dkolhe21/rv32i_5stage/caravel_user_project/signoff/rv32i_top/metrics.csv

design | design_name | config | flow_status | total_runtime | routed_runtime | (Cell/mm^2)/Core_Util | DIEAREA_mm^2 | CellPer_mm^2 | OpenDP_Util | Final_Util | Peak_Memory_Usage_MB | synth_cell_count | tritonRoute_violations | Short_violations | MetSpc_violations | OffGrid_violations | MinHole_violations | Other_violations | Magic_violations | pin_antenna_violations | net_antenna_violations | lvs_total_errors | cvc_total_errors | klayout_violations | wire_length | vias | wns | pl_wns | optimized_wns | fastroute_wns | spef_wns | tns | pl_tns | optimized_tns | fastroute_tns | spef_tns | HPWL | routing_layer1_pct | routing_layer2_pct | routing_layer3_pct | routing_layer4_pct | routing_layer5_pct | routing_layer6_pct | wires_count | wire_bits | public_wires_count | public_wire_bits | memories_count | memory_bits | processes_count | cells_pre_abc | AND | DFF | NAND | NOR | OR | XOR | XNOR | MUX
/project/openlane/rv32i_top | rv32i_top | 26_06_17_21_35 | flow completed | 0h25m51s0ms | 0h16m59s0ms | 12163.333333333332 | 2.25 | 4865.333333333333 | 6.59 | -1 | 3448.28 | 8951 | 0 | 0 | 0 | 0 | 0 | 0 | -1 | 32 | 29 | 0 | -1 | -1 | 751256 | 90284 | 0.0 | -1 | -1 | -1 | 0.0 | 0.0 | -1 | -1 | -1 | 0.0 | 578952604.0 | 0.0 | 10.91 | 10.24 | 8.14 | 4.03 | 8.51 | 6456 | 11643 | 215 | 5334 | 0 | 0 | 0 | 8391 | 75 | 0 | 147 | 201 | 859 | 235 | 44 | 2855
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
