dkolhe21/rv32i_5stage/caravel_user_project/signoff/user_proj_example/metrics.csv

design | design_name | config | flow_status | total_runtime | routed_runtime | (Cell/mm^2)/Core_Util | DIEAREA_mm^2 | CellPer_mm^2 | OpenDP_Util | Final_Util | Peak_Memory_Usage_MB | synth_cell_count | tritonRoute_violations | Short_violations | MetSpc_violations | OffGrid_violations | MinHole_violations | Other_violations | Magic_violations | pin_antenna_violations | net_antenna_violations | lvs_total_errors | cvc_total_errors | klayout_violations | wire_length | vias | wns | pl_wns | optimized_wns | fastroute_wns | spef_wns | tns | pl_tns | optimized_tns | fastroute_tns | spef_tns | HPWL | routing_layer1_pct | routing_layer2_pct | routing_layer3_pct | routing_layer4_pct | routing_layer5_pct | routing_layer6_pct | wires_count | wire_bits | public_wires_count | public_wire_bits | memories_count | memory_bits | processes_count | cells_pre_abc | AND | DFF | NAND | NOR | OR | XOR | XNOR | MUX
/home/passant/efabless/caravel_user_project/openlane/user_proj_example | user_proj_example | 23_07_19_18_14 | flow completed | 0h22m55s0ms | 0h4m31s0ms | 315.2056277056277 | 4.928 | 141.84253246753246 | 0.05 | -1 | 5740.3 | 334 | 0 | 0 | 0 | 0 | 0 | 0 | 0 | 4 | 3 | 0 | -1 | -1 | 109324 | 4949 | 0.0 | -1 | -1 | -1 | 0.0 | 0.0 | -1 | -1 | -1 | 0.0 | 92460801.0 | 0.0 | 0.93 | 0.32 | 0.33 | 0.0 | -1 | 185 | 818 | 31 | 664 | 0 | 0 | 0 | 189 | 18 | 0 | 7 | 15 | 20 | 9 | 7 | 65
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
