dkolhe21/rv32i_5stage/caravel_user_project/signoff/user_project_wrapper/metrics.csv

design | design_name | config | flow_status | total_runtime | routed_runtime | (Cell/mm^2)/Core_Util | DIEAREA_mm^2 | CellPer_mm^2 | OpenDP_Util | Final_Util | Peak_Memory_Usage_MB | synth_cell_count | tritonRoute_violations | Short_violations | MetSpc_violations | OffGrid_violations | MinHole_violations | Other_violations | Magic_violations | pin_antenna_violations | net_antenna_violations | lvs_total_errors | cvc_total_errors | klayout_violations | wire_length | vias | wns | pl_wns | optimized_wns | fastroute_wns | spef_wns | tns | pl_tns | optimized_tns | fastroute_tns | spef_tns | HPWL | routing_layer1_pct | routing_layer2_pct | routing_layer3_pct | routing_layer4_pct | routing_layer5_pct | routing_layer6_pct | wires_count | wire_bits | public_wires_count | public_wire_bits | memories_count | memory_bits | processes_count | cells_pre_abc | AND | DFF | NAND | NOR | OR | XOR | XNOR | MUX
/project/openlane/user_project_wrapper | user_project_wrapper | 26_06_18_21_05 | flow completed | 0h4m10s0ms | 0h1m41s0ms | 0.19458281444582815 | 10.2784 | 0.09729140722291407 | -1 | -1 | 569.62 | 1 | 0 | 0 | 0 | 0 | 0 | 0 | 0 | 4 | 4 | 0 | -1 | -1 | 24429 | 30 | 0.0 | -1 | -1 | -1 | 0.0 | 0.0 | -1 | -1 | -1 | 0.0 | -1 | 0.0 | 0.0 | 0.12 | 0.13 | 0.0 | -1 | 19 | 637 | 19 | 637 | 0 | 0 | 0 | 1 | 0 | 0 | 0 | 0 | 0 | 0 | 0 | 0
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
