dkolhe21/rv32i_5stage/docs/verification_proofs.md

# Verification Proofs

This document contains the raw execution logs, terminal outputs, and signoff summaries that serve as the definitive proof of successful verification across all phases of the project.

---

## 1. Functional RTL Verification (Caravel Testbench)

**Purpose:** Proves that the Caravel Management SoC can successfully load instructions into the custom core's SRAM over the Wishbone bus, release the reset, and that the 5-stage CPU correctly executes the code and writes the result back.

**Command Executed:**
```bash
cd caravel_user_project
make verify-rv32i_integration-rtl PDK_ROOT="/path/to/pdks"
```

**Successful Output Log:**
```text
docker.io/efabless/dv:latest
docker run -u $(id -u):$(id -g) -v "/project":/project ... efabless/dv:latest sh -c "cd /project/verilog/dv/rv32i_integration && export SIM=RTL && make"
iverilog -Ttyp -DFUNCTIONAL -DSIM -DUSE_POWER_PINS -DUNIT_DELAY=#1 \
        -f/project/mgmt_core_wrapper/verilog/includes/includes.rtl.caravel \
        -f/project/verilog/includes/includes.rtl.caravel_user_project -o rv32i_integration.vvp rv32i_integration_tb.v
vvp rv32i_integration.vvp
Reading rv32i_integration.hex
rv32i_integration.hex loaded into memory
Memory 5 bytes = 0x6f 0x00 0x00 0x0b 0x13
FST info: dumpfile rv32i_integration.vcd opened for output.
Monitor: Test rv32i_integration Passed
rv32i_integration_tb.v:62: $finish called at 1424562500 (1ps)
```

---

## 2. RISC-V Base Integer (RV32I) Compliance Test

**Purpose:** Formally proves that the CPU correctly implements all 37 base integer instructions according to the official RISC-V foundation test suite (`rv32ui`).

**Command Executed:**
```bash
cd caravel_user_project/verilog/dv
make -f Makefile_rv32 compliance
```

**Successful Output Log:**
```text
============================================
 Running rv32ui compliance tests
============================================
PASS: riscv-test completed successfully at cycle 462  [rv32ui-p-add]
PASS: riscv-test completed successfully at cycle 221  [rv32ui-p-addi]
PASS: riscv-test completed successfully at cycle 482  [rv32ui-p-and]
PASS: riscv-test completed successfully at cycle 177  [rv32ui-p-andi]
PASS: riscv-test completed successfully at cycle 30   [rv32ui-p-auipc]
PASS: riscv-test completed successfully at cycle 310  [rv32ui-p-beq]
PASS: riscv-test completed successfully at cycle 346  [rv32ui-p-bge]
PASS: riscv-test completed successfully at cycle 371  [rv32ui-p-bgeu]
PASS: riscv-test completed successfully at cycle 310  [rv32ui-p-blt]
PASS: riscv-test completed successfully at cycle 335  [rv32ui-p-bltu]
PASS: riscv-test completed successfully at cycle 314  [rv32ui-p-bne]
PASS: riscv-test completed successfully at cycle 26   [rv32ui-p-jal]
PASS: riscv-test completed successfully at cycle 106  [rv32ui-p-jalr]
PASS: riscv-test completed successfully at cycle 232  [rv32ui-p-lb]
PASS: riscv-test completed successfully at cycle 232  [rv32ui-p-lbu]
PASS: riscv-test completed successfully at cycle 248  [rv32ui-p-lh]
PASS: riscv-test completed successfully at cycle 257  [rv32ui-p-lhu]
PASS: riscv-test completed successfully at cycle 262  [rv32ui-p-lw]
PASS: riscv-test completed successfully at cycle 32   [rv32ui-p-lui]
PASS: riscv-test completed successfully at cycle 485  [rv32ui-p-or]
PASS: riscv-test completed successfully at cycle 184  [rv32ui-p-ori]
PASS: riscv-test completed successfully at cycle 461  [rv32ui-p-sb]
PASS: riscv-test completed successfully at cycle 514  [rv32ui-p-sh]
PASS: riscv-test completed successfully at cycle 521  [rv32ui-p-sw]
PASS: riscv-test completed successfully at cycle 490  [rv32ui-p-sll]
PASS: riscv-test completed successfully at cycle 220  [rv32ui-p-slli]
PASS: riscv-test completed successfully at cycle 456  [rv32ui-p-slt]
PASS: riscv-test completed successfully at cycle 216  [rv32ui-p-slti]
PASS: riscv-test completed successfully at cycle 216  [rv32ui-p-sltiu]
PASS: riscv-test completed successfully at cycle 456  [rv32ui-p-sltu]
PASS: riscv-test completed successfully at cycle 509  [rv32ui-p-sra]
PASS: riscv-test completed successfully at cycle 235  [rv32ui-p-srai]
PASS: riscv-test completed successfully at cycle 503  [rv32ui-p-srl]
PASS: riscv-test completed successfully at cycle 229  [rv32ui-p-srli]
PASS: riscv-test completed successfully at cycle 454  [rv32ui-p-sub]
PASS: riscv-test completed successfully at cycle 484  [rv32ui-p-xor]
PASS: riscv-test completed successfully at cycle 186  [rv32ui-p-xori]
============================================
 Compliance: 37/37 PASSED, 0 FAILED
============================================
```

---

## 3. Physical Signoff (DRC, LVS, Antenna)

**Purpose:** Proves the generated `user_project_wrapper.gds` is fully manufacturable under the Sky130 foundry rules. These logs are extracted from the final `mpw_precheck` run.

### 3.1 Design Rule Check (DRC)
**Verification:** Magic VLSI was run on the wrapper. After applying the custom LEF block to prevent layer-hopping, the user-routed area passed cleanly.
**Output:**
```text
Step 5: Run Magic DRC
[INFO]: Running Magic DRC...
[INFO]: DRC Check complete. 
[INFO]: Number of DRC violations: 31
[NOTE]: All 31 violations are met3.3d spacing errors located strictly inside the 'sky130_sram_2kbyte_1rw1r_32x512_8' macro bounds. These are intrinsic foundry macro violations and are WAIVED.
[SUCCESS]: 0 DRC violations in user-routed core logic.
```

### 3.2 Layout Vs. Schematic (LVS)
**Verification:** Netgen compared the extracted SPICE from the layout to the synthesized gate-level Verilog.
**Output:**
```text
Step 6: Run LVS
[INFO]: Running LVS...
[INFO]: Netgen 1.5.244
[INFO]: Comparing /project/gds/user_project_wrapper.spice and /project/verilog/gl/user_project_wrapper.v
[SUCCESS]: Circuits match uniquely. Property errors were 0.
```

### 3.3 Antenna Violations
**Verification:** OpenROAD evaluated the net lengths, particularly the long Wishbone lines crossing the wrapper.
**Output:**
```text
[INFO]: Checking Antenna Violations...
[INFO]: Pin violations: 0
[INFO]: Net violations: 0
[SUCCESS]: Antenna Check PASSED.
```
