dkolhe21/rv32i_5stage/caravel_user_project/openlane/user_project_wrapper/rv32i_top_stub.v

module rv32i_top (
`ifdef USE_POWER_PINS
    inout vccd1,
    inout vssd1,
    inout vccd2,
    inout vssd2,
    inout vdda1,
    inout vssa1,
    inout vdda2,
    inout vssa2,
`endif
    input  clk,
    input  rst,

    // Wishbone Interface
    input         wb_clk_i,
    input         wb_rst_i,
    input         wbs_stb_i,
    input         wbs_cyc_i,
    input         wbs_we_i,
        input \wbs_sel_i[0] ,
    input \wbs_sel_i[1] ,
    input \wbs_sel_i[2] ,
    input \wbs_sel_i[3] ,
        input \wbs_dat_i[0] ,
    input \wbs_dat_i[1] ,
    input \wbs_dat_i[2] ,
    input \wbs_dat_i[3] ,
    input \wbs_dat_i[4] ,
    input \wbs_dat_i[5] ,
    input \wbs_dat_i[6] ,
    input \wbs_dat_i[7] ,
    input \wbs_dat_i[8] ,
    input \wbs_dat_i[9] ,
    input \wbs_dat_i[10] ,
    input \wbs_dat_i[11] ,
    input \wbs_dat_i[12] ,
    input \wbs_dat_i[13] ,
    input \wbs_dat_i[14] ,
    input \wbs_dat_i[15] ,
    input \wbs_dat_i[16] ,
    input \wbs_dat_i[17] ,
    input \wbs_dat_i[18] ,
    input \wbs_dat_i[19] ,
    input \wbs_dat_i[20] ,
    input \wbs_dat_i[21] ,
    input \wbs_dat_i[22] ,
    input \wbs_dat_i[23] ,
    input \wbs_dat_i[24] ,
    input \wbs_dat_i[25] ,
    input \wbs_dat_i[26] ,
    input \wbs_dat_i[27] ,
    input \wbs_dat_i[28] ,
    input \wbs_dat_i[29] ,
    input \wbs_dat_i[30] ,
    input \wbs_dat_i[31] ,
        input \wbs_adr_i[0] ,
    input \wbs_adr_i[1] ,
    input \wbs_adr_i[2] ,
    input \wbs_adr_i[3] ,
    input \wbs_adr_i[4] ,
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
    output \la_data_out[111] ,
    output \la_data_out[112] ,
    output \la_data_out[113] ,
    output \la_data_out[114] ,
    output \la_data_out[115] ,
    output \la_data_out[116] ,
    output \la_data_out[117] ,
    output \la_data_out[118] ,
    output \la_data_out[119] ,
    output \la_data_out[120] ,
    output \la_data_out[121] ,
    output \la_data_out[122] ,
    output \la_data_out[123] ,
    output \la_data_out[124] ,
    output \la_data_out[125] ,
    output \la_data_out[126] ,
    output \la_data_out[127]
);
endmodule
