dkolhe21/rv32i_5stage/caravel_user_project/openlane/verilog/gl/user_project_wrapper.nl.v

// This is the unpowered netlist.
module user_project_wrapper (user_clock2,
    wb_clk_i,
    wb_rst_i,
    wbs_ack_o,
    wbs_cyc_i,
    wbs_stb_i,
    wbs_we_i,
    analog_io,
    io_in,
    io_oeb,
    io_out,
    la_data_in,
    la_data_out,
    la_oenb,
    user_irq,
    wbs_adr_i,
    wbs_dat_i,
    wbs_dat_o,
    wbs_sel_i);
 input user_clock2;
 input wb_clk_i;
 input wb_rst_i;
 output wbs_ack_o;
 input wbs_cyc_i;
 input wbs_stb_i;
 input wbs_we_i;
 inout [28:0] analog_io;
 input [37:0] io_in;
 output [37:0] io_oeb;
 output [37:0] io_out;
 input [127:0] la_data_in;
 output [127:0] la_data_out;
 input [127:0] la_oenb;
 output [2:0] user_irq;
 input [31:0] wbs_adr_i;
 input [31:0] wbs_dat_i;
 output [31:0] wbs_dat_o;
 input [3:0] wbs_sel_i;


 rv32i_top mprj (.bist_mode_ext(la_data_in[123]),
    .clk(wb_clk_i),
    .jtag_tck(la_data_in[127]),
    .jtag_tdi(la_data_in[125]),
    .jtag_tms(la_data_in[126]),
    .jtag_trst_n(la_data_in[124]),
    .wb_clk_i(wb_clk_i),
    .wb_rst_i(wb_rst_i),
    .wbs_ack_o(wbs_ack_o),
    .wbs_cyc_i(wbs_cyc_i),
    .wbs_stb_i(wbs_stb_i),
    .wbs_we_i(wbs_we_i),
    .io_oeb({_NC1,
    _NC2,
    _NC3,
    _NC4,
    _NC5,
    _NC6,
    _NC7,
    _NC8,
    _NC9,
    _NC10,
    _NC11,
    _NC12,
    _NC13,
    _NC14,
    _NC15,
    _NC16,
    _NC17,
    _NC18,
    _NC19,
    _NC20,
    _NC21,
    _NC22,
    _NC23,
    _NC24,
    _NC25,
    _NC26,
    _NC27,
    _NC28,
    _NC29,
    _NC30,
    _NC31,
    _NC32,
    _NC33,
    _NC34,
    _NC35,
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
    _NC286,
    _NC287,
    _NC288,
    _NC289,
    _NC290,
    _NC291,
    _NC292,
    _NC293,
    _NC294,
    _NC295,
    _NC296,
    _NC297,
    _NC298,
    _NC299,
    _NC300,
    _NC301,
    _NC302,
    _NC303}),
    .wbs_sel_i({_NC304,
    _NC305,
    _NC306,
    _NC307}));
endmodule
