dkolhe21/rv32i_5stage/caravel_user_project/verilog/dv/rv32i_integration/rv32i_integration_tb.v

// SPDX-FileCopyrightText: 2020 Efabless Corporation
//
// Licensed under the Apache License, Version 2.0 (the "License");
// you may not use this file except in compliance with the License.
// You may obtain a copy of the License at
//
//      http://www.apache.org/licenses/LICENSE-2.0
//
// Unless required by applicable law or agreed to in writing, software
// distributed under the License is distributed on an "AS IS" BASIS,
// WITHOUT WARRANTIES OR CONDITIONS OF ANY KIND, either express or implied.
// See the License for the specific language governing permissions and
// limitations under the License.
// SPDX-License-Identifier: Apache-2.0

`default_nettype none

`timescale 1 ns / 1 ps

module rv32i_integration_tb;
    reg clock;
    reg RSTB;
    reg CSB;
    reg power1, power2;
    reg power3, power4;

    wire gpio;
    wire [37:0] mprj_io;
    wire [15:0] checkbits;

    assign checkbits = mprj_io[31:16];

    assign mprj_io[3] = (CSB == 1'b1) ? 1'b1 : 1'bz;

    always #12.5 clock <= (clock === 1'b0);

    initial begin
        clock = 0;
    end

    initial begin
        $dumpfile("rv32i_integration.vcd");
        $dumpvars(0, rv32i_integration_tb);

        // Repeat cycles of 1000 clock edges as needed to complete testbench
        repeat (250) begin
            repeat (1000) @(posedge clock);
        end
        $display("%c[1;31m",27);
        `ifdef GL
            $display ("Monitor: Timeout, rv32i_integration (GL) Failed");
        `else
            $display ("Monitor: Timeout, rv32i_integration (RTL) Failed");
        `endif
        $display("%c[0m",27);
        $finish;
    end

    initial begin
        wait(checkbits == 16'hABBA);
        $display("Monitor: Test rv32i_integration Passed");
        $finish;
    end

    initial begin
        wait(checkbits == 16'hDEAD);
        $display("Monitor: Test rv32i_integration Failed");
        $finish;
    end

    initial begin
        RSTB <= 1'b0;
        CSB  <= 1'b1;       // Force CSB high
        #2000;
        RSTB <= 1'b1;       // Release reset
        #3_00_000;
        CSB = 1'b0;         // CSB can be released
    end

    initial begin       // Power-up sequence
        power1 <= 1'b0;
        power2 <= 1'b0;
        power3 <= 1'b0;
        power4 <= 1'b0;
        #100;
        power1 <= 1'b1;
        #100;
        power2 <= 1'b1;
        #100;
        power3 <= 1'b1;
        #100;
        power4 <= 1'b1;
    end

    wire flash_csb;
    wire flash_clk;
    wire flash_io0;
    wire flash_io1;

    wire VDD3V3;
    wire VDD1V8;
    wire VSS;
    
    assign VDD3V3 = power1;
    assign VDD1V8 = power2;
    assign VSS = 1'b0;

    caravel uut (
        .vddio    (VDD3V3),
        .vddio_2  (VDD3V3),
        .vssio    (VSS),
        .vssio_2  (VSS),
        .vdda     (VDD3V3),
        .vssa     (VSS),
        .vccd     (VDD1V8),
        .vssd     (VSS),
        .vdda1    (VDD3V3),
        .vdda1_2  (VDD3V3),
        .vdda2    (VDD3V3),
        .vssa1    (VSS),
        .vssa1_2  (VSS),
        .vssa2    (VSS),
        .vccd1    (VDD1V8),
        .vccd2    (VDD1V8),
        .vssd1    (VSS),
        .vssd2    (VSS),
        .clock    (clock),
        .gpio     (gpio),
        .mprj_io  (mprj_io),
        .flash_csb(flash_csb),
        .flash_clk(flash_clk),
        .flash_io0(flash_io0),
        .flash_io1(flash_io1),
        .resetb   (RSTB)
    );

    spiflash #(
        .FILENAME("rv32i_integration.hex")
    ) spiflash (
        .csb(flash_csb),
        .clk(flash_clk),
        .io0(flash_io0),
        .io1(flash_io1),
        .io2(),         // not used
        .io3()          // not used
    );

endmodule
`default_nettype wire
