dkolhe21/rv32i_5stage/(commit log)

2026-06-20 Initial commit: 5-Stage RV32I Core with Caravel Wrapper Integration
    [macro.cfg, metrics.csv, pin_order.cfg, user_proj_example.Fastest.sdf, user_proj_example.Slowest.sdf, user_proj_example.Typical.sdf, user_project_wrapper.Fastest.sdf, user_project_wrapper.Slowest.sdf]
2026-06-20 docs: fix SVG y-axis coordinate spacing and expand viewBox height to strictly 340px to eliminate tight clipping and overlapping text artifacts
